NikhilMotagi/ModBusPlug/Illustration/ModbusPlug_Circuit1.png

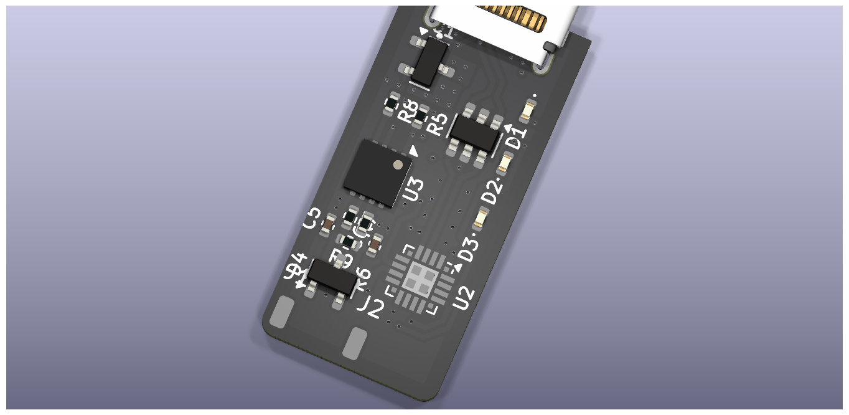
Illustration/ModbusPlug_Circuit1.png
