NikhilMotagi/ModBusPlug/Illustration/ModbusPlug_Circuit3.png

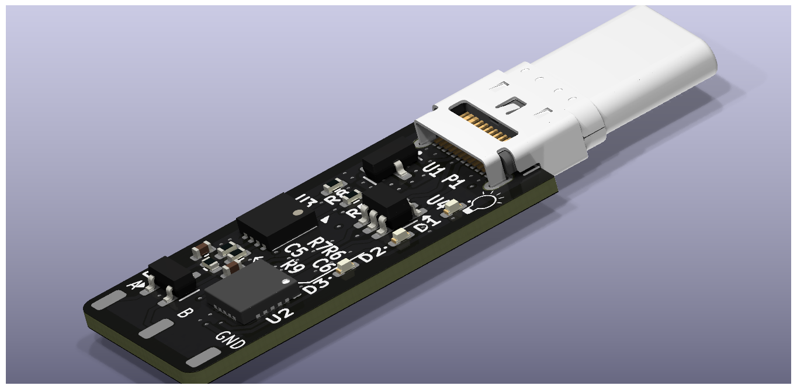
Illustration/ModbusPlug_Circuit3.png
