NikhilMotagi/ModBusPlug/Illustration/ModbusPlug_Circuit7.png

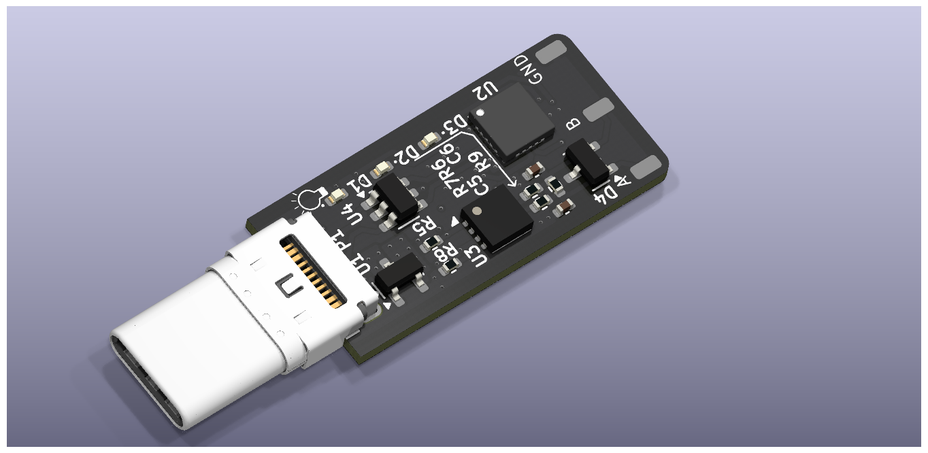
Illustration/ModbusPlug_Circuit7.png
