NikhilMotagi/ModBusPlug/Illustration/ModbusPlug_Circuit8.png

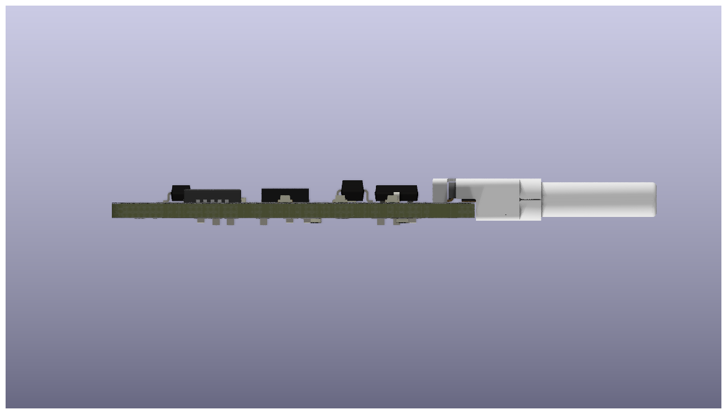
Illustration/ModbusPlug_Circuit8.png
