NikhilMotagi/ModBusPlug/Illustration/shell_1.png

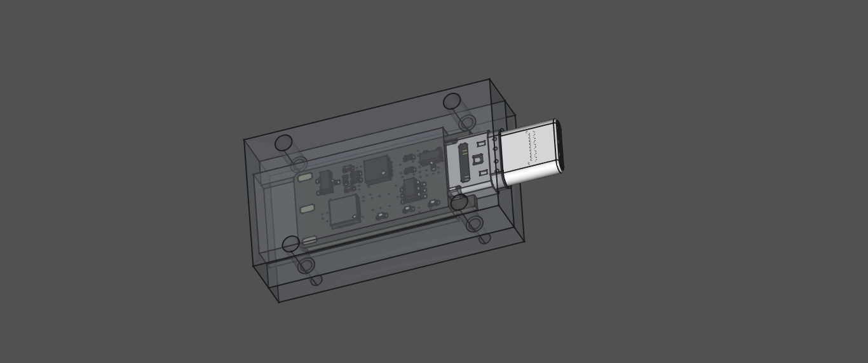
Illustration/shell_1.png
