NikhilMotagi/ModBusPlug/Illustration/shell_2.png

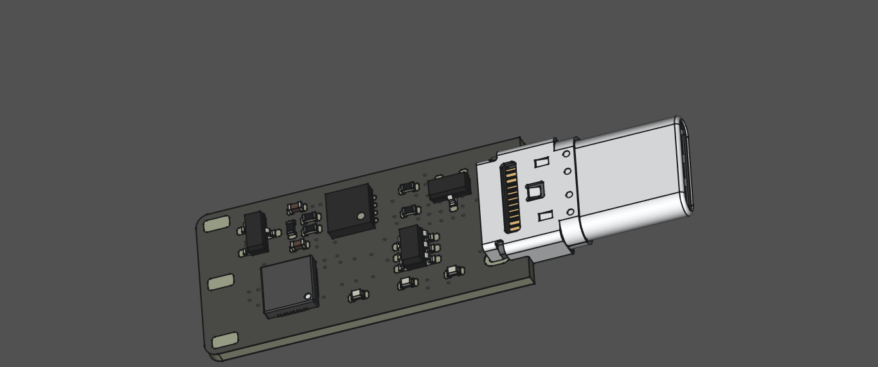
Illustration/shell_2.png
