NikhilMotagi/ModBusPlug/Illustration/shell_3.png

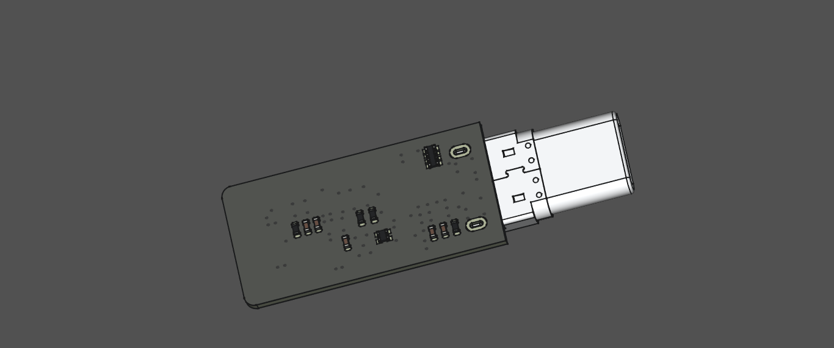
Illustration/shell_3.png
