NikhilMotagi/ModBusPlug/Illustration/shell_4.png

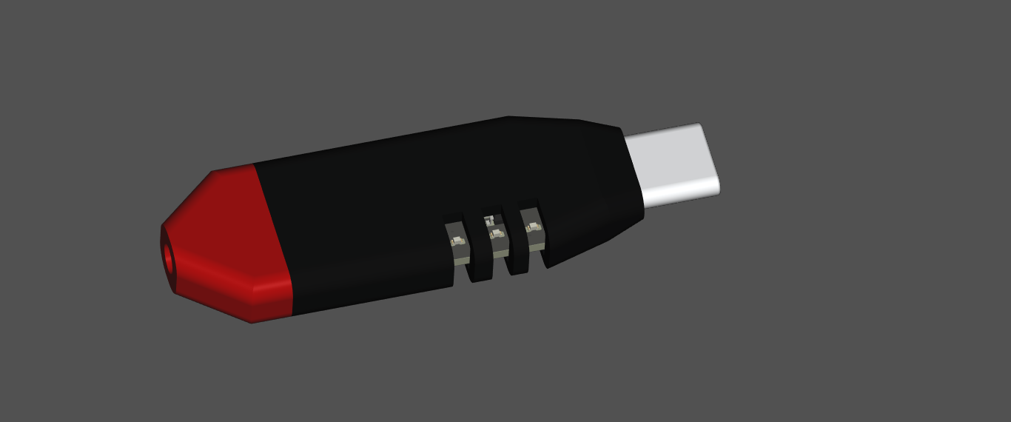
Illustration/shell_4.png
