NikhilMotagi/ModBusPlug/Illustration/shell_airender2.png

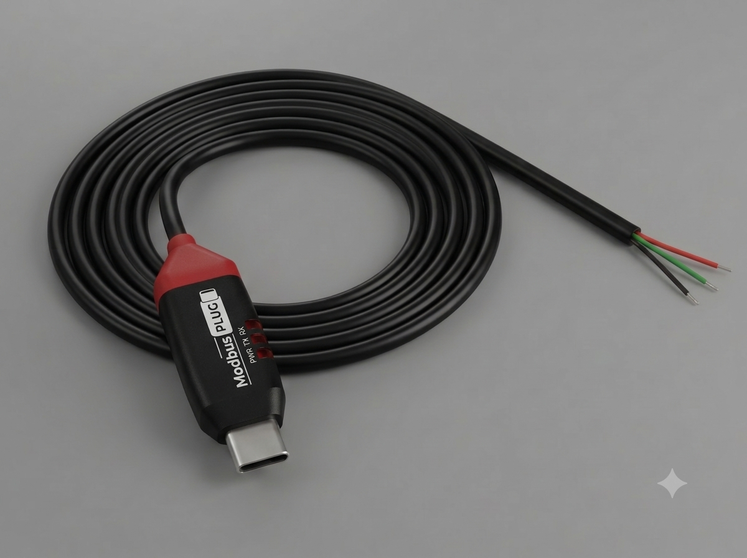
Illustration/shell_airender2.png
