NikhilMotagi/ModBusPlug/Media/BrigthLABS (1).png

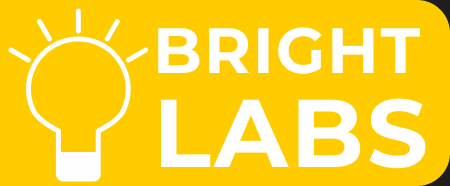
Media/BrigthLABS (1).png
