NikhilMotagi/ModBusPlug/Media/BrigthLABS.png

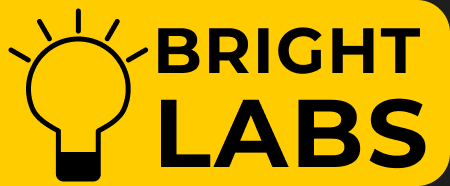
Media/BrigthLABS.png
