NikhilMotagi/ModBusPlug/Media/Gemini_Generated_Image_so0ew5so0ew5so0e.png

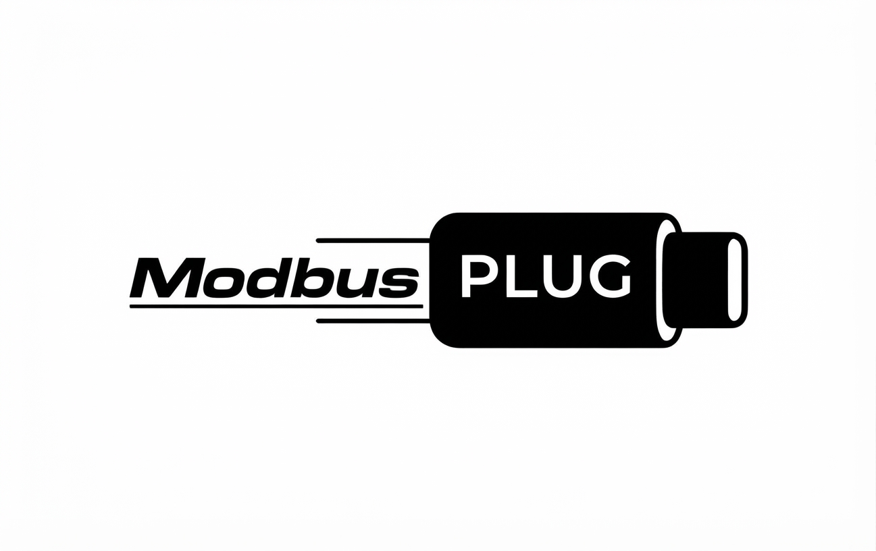
Media/Gemini_Generated_Image_so0ew5so0ew5so0e.png
