NikhilMotagi/ModBusPlug/Media/Modbus Plug with Color LEDs and Cable.png

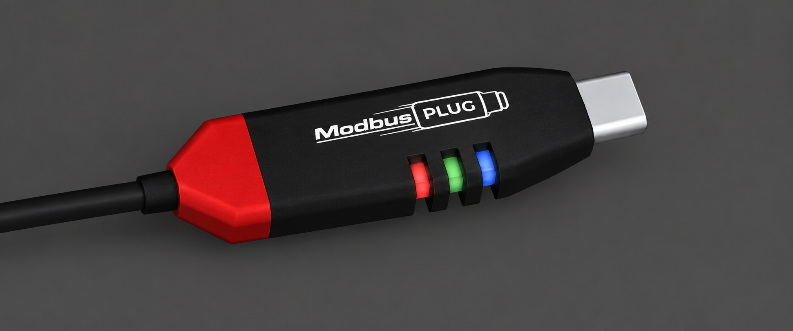
Media/Modbus Plug with Color LEDs and Cable.png
