NikhilMotagi/ModBusPlug/Media/OG OG Bulb Thick.png

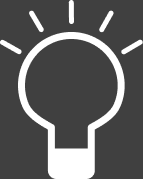
Media/OG OG Bulb Thick.png
