NikhilMotagi/ModBusPlug/Media/WhatsApp Image 2026-10-03 at 10.42.25 AM.jpeg

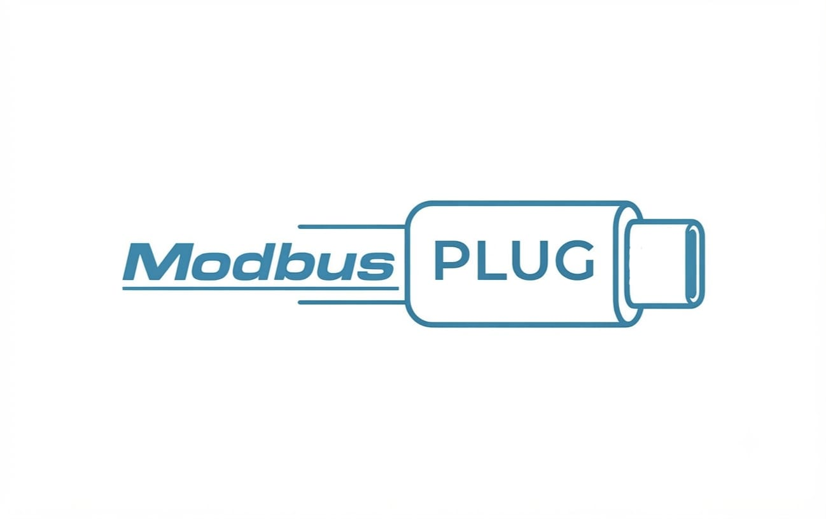
Media/WhatsApp Image 2026-10-03 at 10.42.25 AM.jpeg
