NikhilMotagi/ModBusPlug/Fab/ModbusPlug_Circuit-NPTH-drl_map.dxf

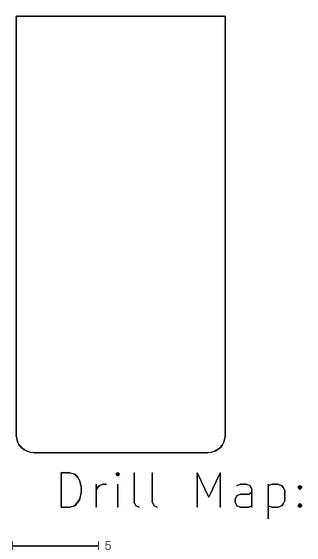
[picture p26: CAD file, 2026-10-03]
Fab/ModbusPlug_Circuit-NPTH-drl_map.dxf
16.4 x 28.9
