NikhilMotagi/ModBusPlug/ModbusPlug_Circuit/ModbusPlug_Library/3dCad/USB4155-03-C--3DModel-STEP-1.STEP

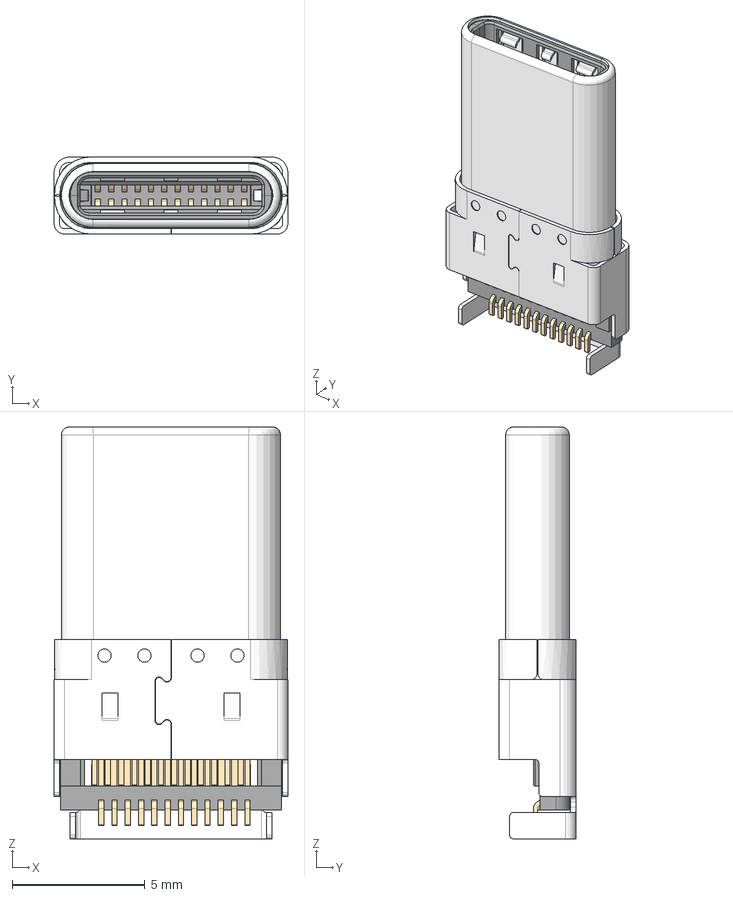
[picture p28: CAD file, 2026-09-18]
ModbusPlug_Circuit/ModbusPlug_Library/3dCad/USB4155-03-C--3DModel-STEP-1.STEP
8.80 x 2.90 x 15.5 mm
ÊäÈë1 x 7
ÇÐ³ý-ÀÉì2
