NikhilMotagi/ModBusPlug/Fab/ModbusPlug_Circuit-PTH-drl_map.dxf

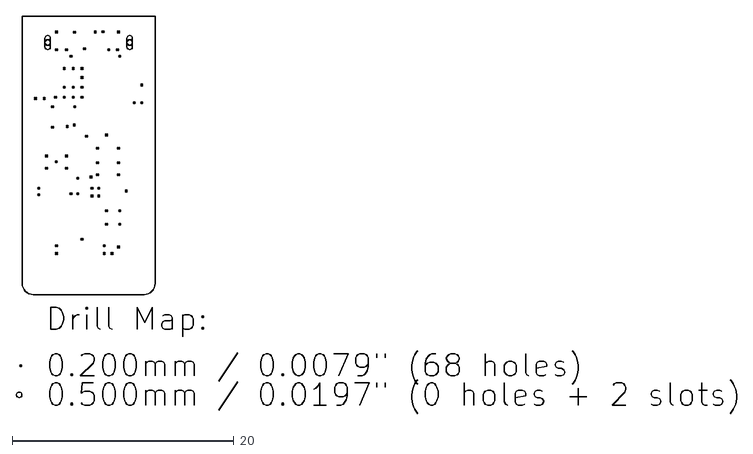
[picture p29: CAD file, 2026-10-03]
Fab/ModbusPlug_Circuit-PTH-drl_map.dxf
65.0 x 35.8
