NikhilMotagi/ModBusPlug/Illustration/PCB_Shell_v1.FCStd

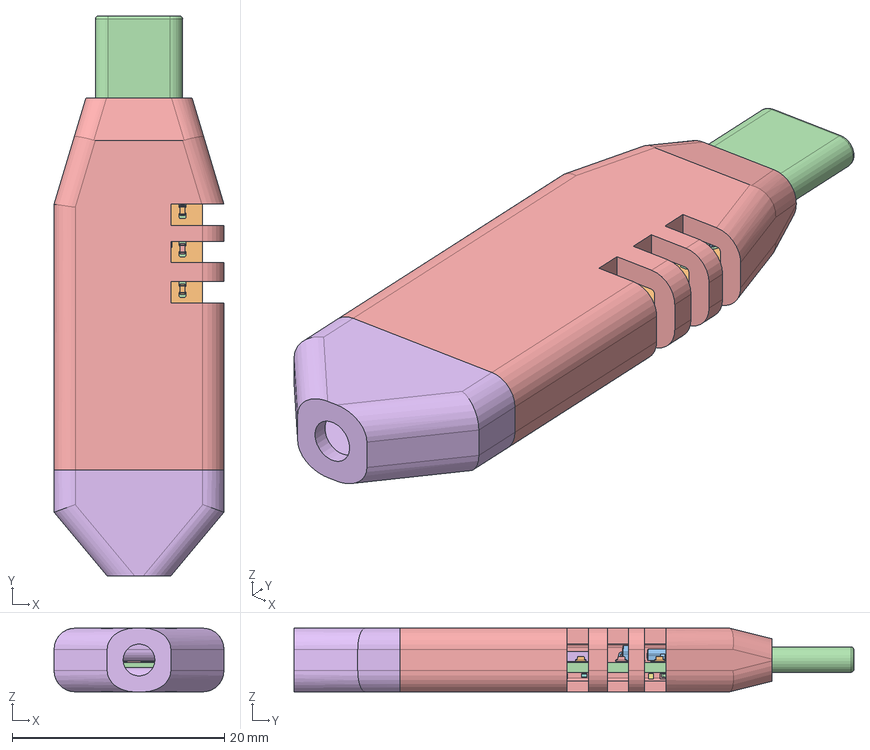
[picture p30: CAD file, 2026-10-17]
Illustration/PCB_Shell_v1.FCStd
16.0 x 52.7 x 6.00 mm
R_0402_1005Metric
LED_0402_1005Metric
SOT-23-6
ÃÂÃÂ¤ÃÂÃÂ«1
ÃÂÃÂ¤ÃÂÃÂ«002
ÃÂÃÂ¤ÃÂÃÂ«003
ÃÂÃÂ¤ÃÂÃÂ«004
ÃÂÃÂ¤ÃÂÃÂ«005
ÃÂÃÂ¤ÃÂÃÂ«006
ÃÂÃÂ¤ÃÂÃÂ«007
ÃÂÃÂ¤ÃÂÃÂ«008
ÃÂÃÂ¤ÃÂÃÂ«009
ÃÂÃÂ¤ÃÂÃÂ«010
ÃÂÃÂ¤ÃÂÃÂ«011
ÃÂÃÂ¤ÃÂÃÂ«012
ÃÂÃÂ¤ÃÂÃÂ«013
ÃÂÃÂ¤ÃÂÃÂ«014
ÃÂÃÂ¤ÃÂÃÂ«015
ÃÂÃÂ¤ÃÂÃÂ«016
ÃÂÃÂ¤ÃÂÃÂ«017
ÃÂÃÂ¤ÃÂÃÂ«018
ÃÂÃÂ¤ÃÂÃÂ«019
ÃÂÃÂ¤ÃÂÃÂ«020
ÃÂÃÂ¤ÃÂÃÂ«021
ÃÂÃÂ¤ÃÂÃÂ«022
ÃÂÃÂ¤ÃÂÃÂ«023
ÃÂÃÂ¤ÃÂÃÂ«024
ÃÂÃÂ¤ÃÂÃÂ«025
ÃÂÃÂ¤ÃÂÃÂ«026
ÃÂÃÂ¤ÃÂÃÂ«027
ÃÂÃÂ¤ÃÂÃÂ«028
ÃÂÃÂ¤ÃÂÃÂ«029
ÃÂÃÂ¤ÃÂÃÂ«030
ÃÂÃÂ¤ÃÂÃÂ«031
ÃÂÃÂ¤ÃÂÃÂ«032
ÃÂÃÂ¤ÃÂÃÂ«033
ÃÂÃÂ¤ÃÂÃÂ«034
ÃÂÃÂ¤ÃÂÃÂ«035
ÃÂÃÂ¤ÃÂÃÂ«036
ÃÂÃÂ¤ÃÂÃÂ«037
ÃÂÃÂ¤ÃÂÃÂ«038
ÃÂÃÂ¤ÃÂÃÂ«039
ÃÂÃÂ¤ÃÂÃÂ«040
ÃÂÃÂ¤ÃÂÃÂ«041
ÃÂÃÂ¤ÃÂÃÂ«042
ÃÂÃÂ¤ÃÂÃÂ«043
ÃÂÃÂ¤ÃÂÃÂ«044
ÃÂÃÂ¤ÃÂÃÂ«045
ÃÂÃÂ¤ÃÂÃÂ«046
ÃÂÃÂ¤ÃÂÃÂ«047
ÃÂÃÂ¤ÃÂÃÂ«048
ÃÂÃÂ¤ÃÂÃÂ«049
ÃÂÃÂ¤ÃÂÃÂ«050
ÃÂÃÂ¤ÃÂÃÂ«051
ÃÂÃÂ¤ÃÂÃÂ«052
ÃÂÃÂ¤ÃÂÃÂ«053
ÃÂÃÂ¤ÃÂÃÂ«054
ÃÂÃÂ¤ÃÂÃÂ«055
ÃÂÃÂ¤ÃÂÃÂ«056
ÃÂÃÂ¤ÃÂÃÂ«057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
