NikhilMotagi/ModBusPlug/Illustration/ModbusPlug_Circuit-NPTH-drl_map.dxf

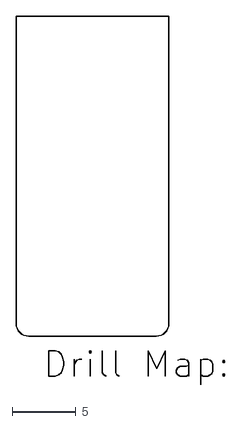
[picture p31: CAD file, 2026-10-03]
Illustration/ModbusPlug_Circuit-NPTH-drl_map.dxf
16.4 x 28.9
