NikhilMotagi/ModBusPlug/Illustration/ModbusPlug_Circuit.step

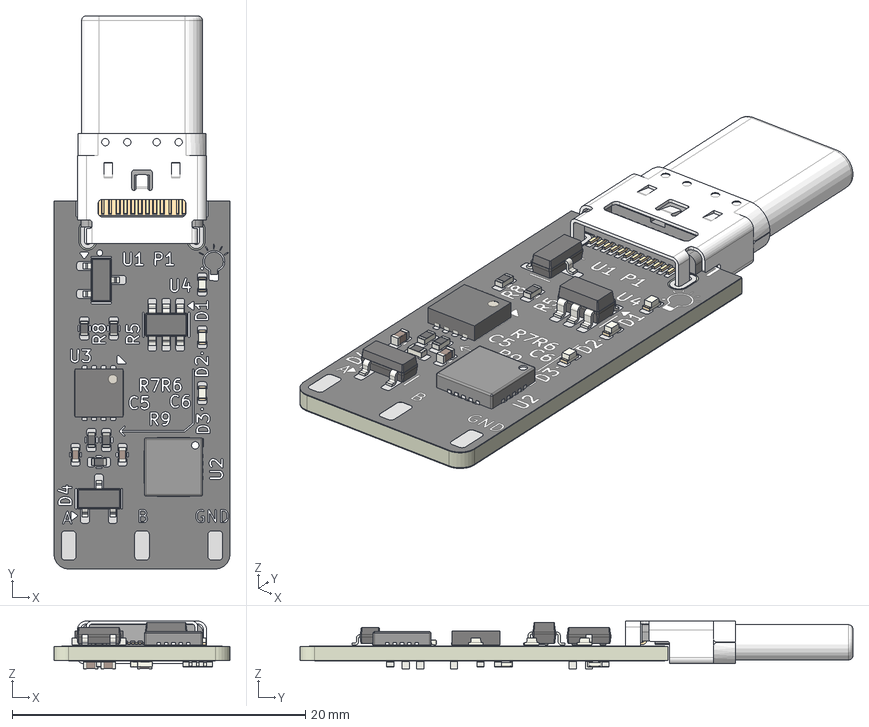
[picture p32: CAD file, 2026-10-03]
Illustration/ModbusPlug_Circuit.step
12.0 x 37.7 x 3.27 mm
R_0402_1005Metric x 9
LED_0402_1005Metric x 3
SOT-23-6
ÊäÈë1 x 7
ÇÐ³ý-ÀÉì2
SOT-23 x 2
C_0402_1005Metric x 7
VSON-8_3.3x3.3mm_P0.65mm_NexFET
R_Array_Convex_2x0402
R_Array_Convex_4x0402
ModbusPlug_Circuit_copper
ModbusPlug_Circuit_pad
ModbusPlug_Circuit_via
ModbusPlug_Circuit_silkscreen
ModbusPlug_Circuit_soldermask
ModbusPlug_Circuit_PCB
