NikhilMotagi/ModBusPlug/Illustration/ModbusPlug_Circuit-PTH-drl_map.dxf

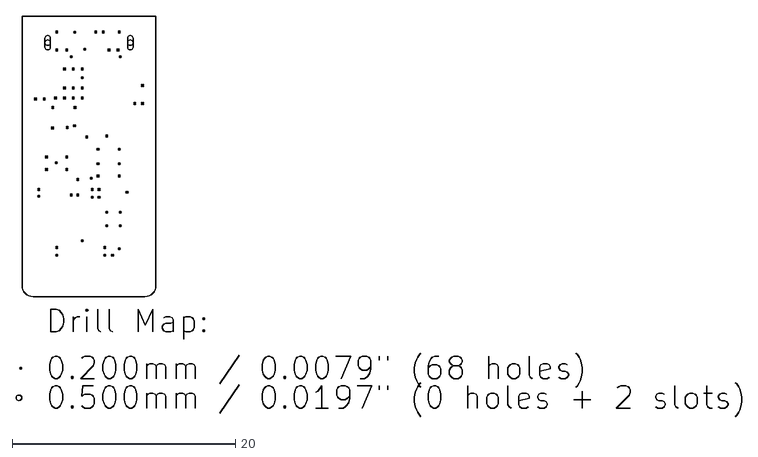
[picture p33: CAD file, 2026-10-03]
Illustration/ModbusPlug_Circuit-PTH-drl_map.dxf
65.0 x 35.8
