NikhilMotagi/ModBusPlug/ModbusPlug_Circuit/ModbusPlug_Circuit.kicad_pcb

## KiCad design ModbusPlug_Circuit/ModbusPlug_Circuit.kicad_pcb (2026-10-03)

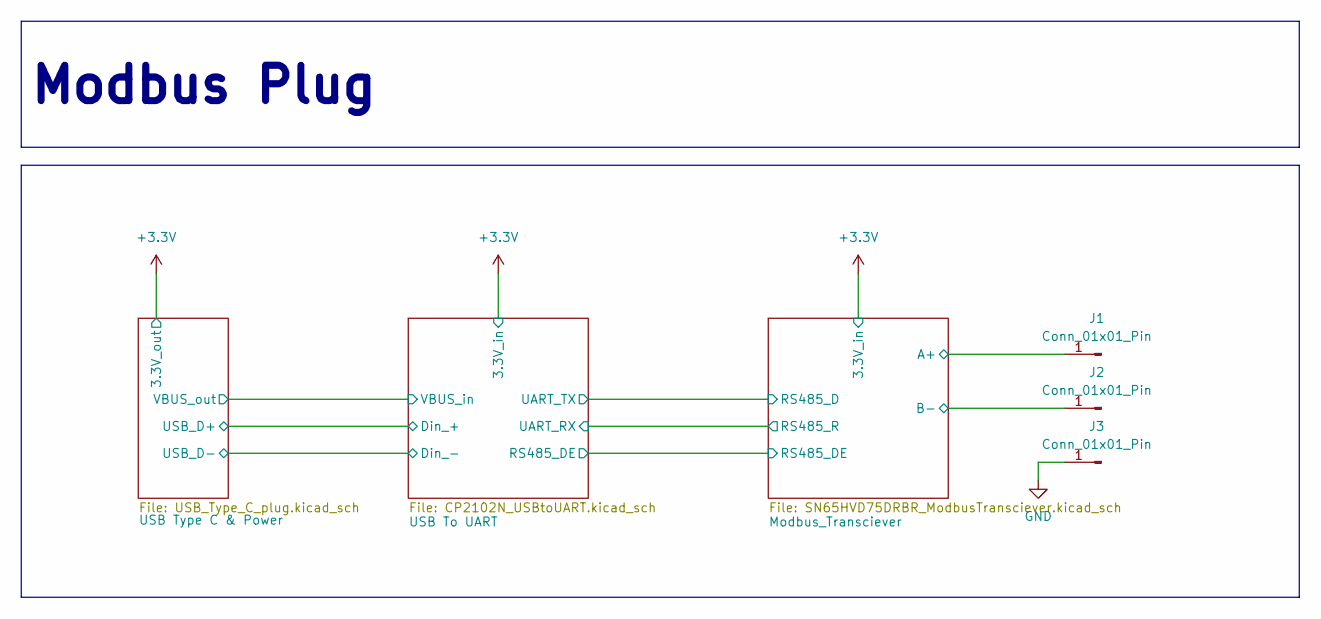
[picture p34: schematic ModbusPlug_Circuit.kicad_sch, ModbusPlug]

Parts:
J1, J2, J3: Conn_01x01_Pin; SolderWirePad_1x01_SMD_1x2mm

Connections:
/Modbus_Transciever/A+: J1.1; also elsewhere on the board
/Modbus_Transciever/B-: J2.1; also elsewhere on the board
GND: J3.1; also elsewhere on the board

Notes on the sheet:
Modbus Plug

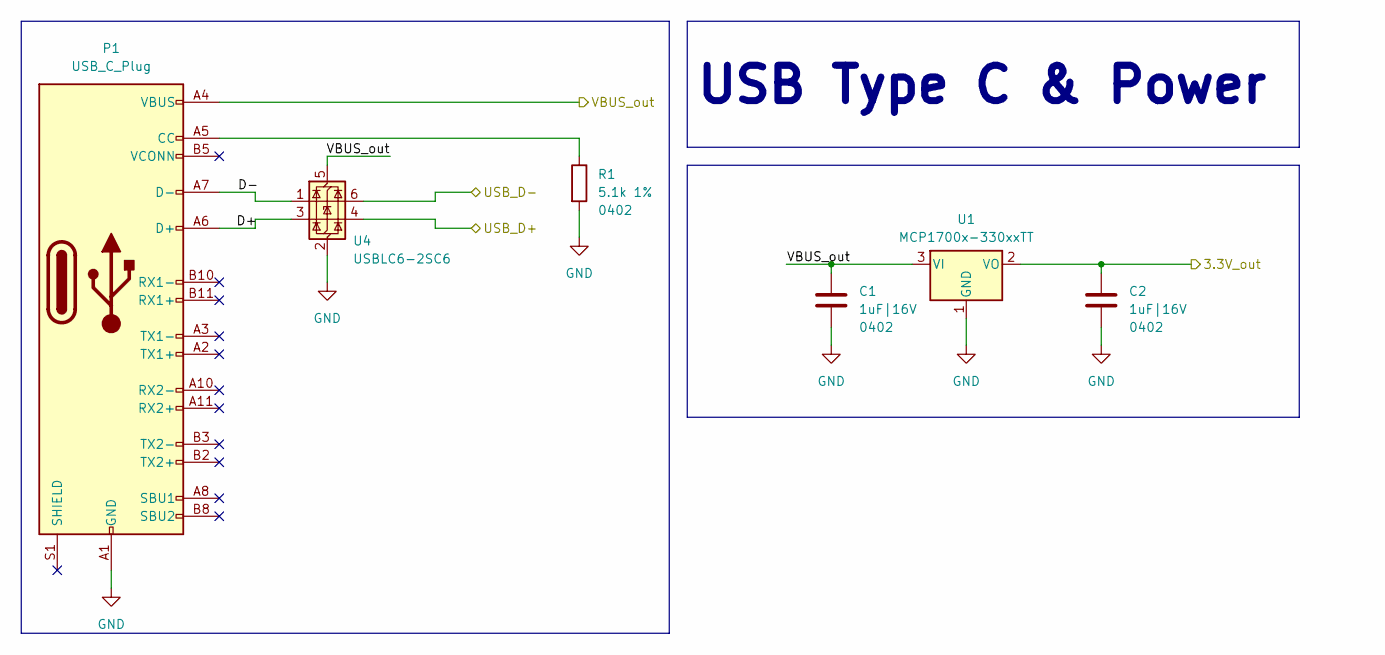
[picture p35: schematic USB_Type_C_plug.kicad_sch, ModbusPlug]

Parts:
C1, C2: 1uF|16V; C_0402_1005Metric
P1: USB_C_Plug; GCT_USB4155-03-C_REVA; PARTREV A
R1: 5.1k 1%; R_0402_1005Metric
U1: MCP1700x-330xxTT; SOT-23
U4: USBLC6-2SC6; SOT-23-6

Connections:
+3.3V: C2.1, U1.2 (VO); also elsewhere on the board
/USB To UART/Din_+: U4.4 (I/O2); also elsewhere on the board
/USB To UART/Din_-: U4.6 (I/O1); also elsewhere on the board
/USB Type C & Power/D+: P1.A6 (D+), P1.B6 (D+), U4.3 (I/O2)
/USB Type C & Power/D-: P1.A7 (D-), P1.B7 (D-), U4.1 (I/O1)
/USB Type C & Power/VBUS_out: C1.1, P1.A4 (VBUS), P1.A9 (VBUS), P1.B4 (VBUS), P1.B9 (VBUS), U1.3 (VI), U4.5 (VBUS); also elsewhere on the board
GND: C1.2, C2.2, P1.A1 (GND), P1.A12 (GND), P1.B1 (GND), P1.B12 (GND), R1.2, U1.1 (GND), U4.2 (GND); also elsewhere on the board
unnamed: P1.A5 (CC), R1.1

Notes on the sheet:
USB Type C & Power

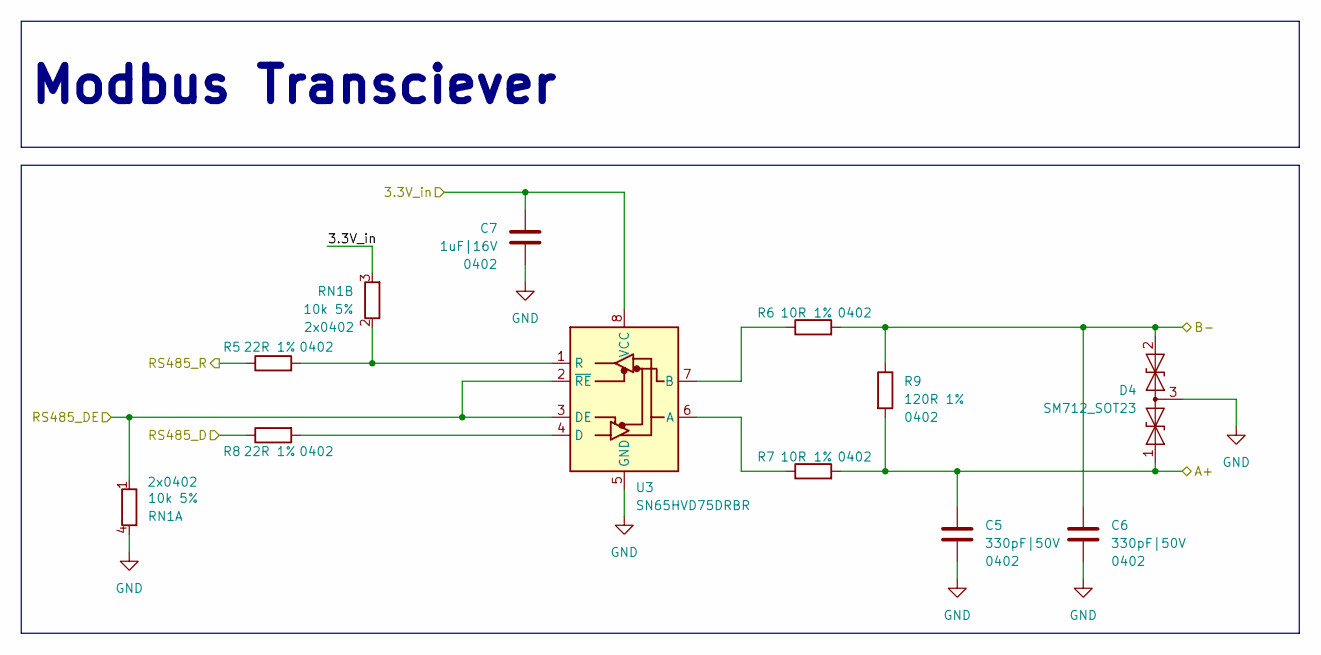
[picture p36: schematic SN65HVD75DRBR_ModbusTransciever.kicad_sch, ModbusPlug]

Parts:
C5, C6: 330pF|50V; C_0402_1005Metric
C7: 1uF|16V; C_0402_1005Metric
D4: SM712_SOT23; SOT-23
R5, R8: 22R 1%; R_0402_1005Metric
R6, R7: 10R 1%; R_0402_1005Metric
R9: 120R 1%; R_0402_1005Metric
RN1: 10k 5%; R_Array_Convex_2x0402
U3: SN65HVD75DRBR; VSON-8-1EP_3x3mm_P0.65mm_EP1.65x2.4mm

Connections:
+3.3V: C7.1, RN1.3 (R2.2), U3.8 (VCC); also elsewhere on the board
/Modbus_Transciever/A+: C5.1, D4.1 (A1), R7.2, R9.2; also elsewhere on the board
/Modbus_Transciever/B-: C6.1, D4.2 (A2), R6.2, R9.1; also elsewhere on the board
/Modbus_Transciever/RS485_D: R8.1; also elsewhere on the board
/Modbus_Transciever/RS485_DE: RN1.1 (R1.1), U3.2 (~RE), U3.3 (DE); also elsewhere on the board
/Modbus_Transciever/RS485_R: R5.1; also elsewhere on the board
GND: C5.2, C6.2, C7.2, D4.3 (common), RN1.4 (R1.2), U3.5 (GND), U3.9 (EPad); also elsewhere on the board
unnamed: R5.2, RN1.2 (R2.1), U3.1 (R)
unnamed: R7.1, U3.6 (A)
unnamed: R6.1, U3.7 (B)
unnamed: R8.2, U3.4 (D)

Notes on the sheet:
Modbus Transciever

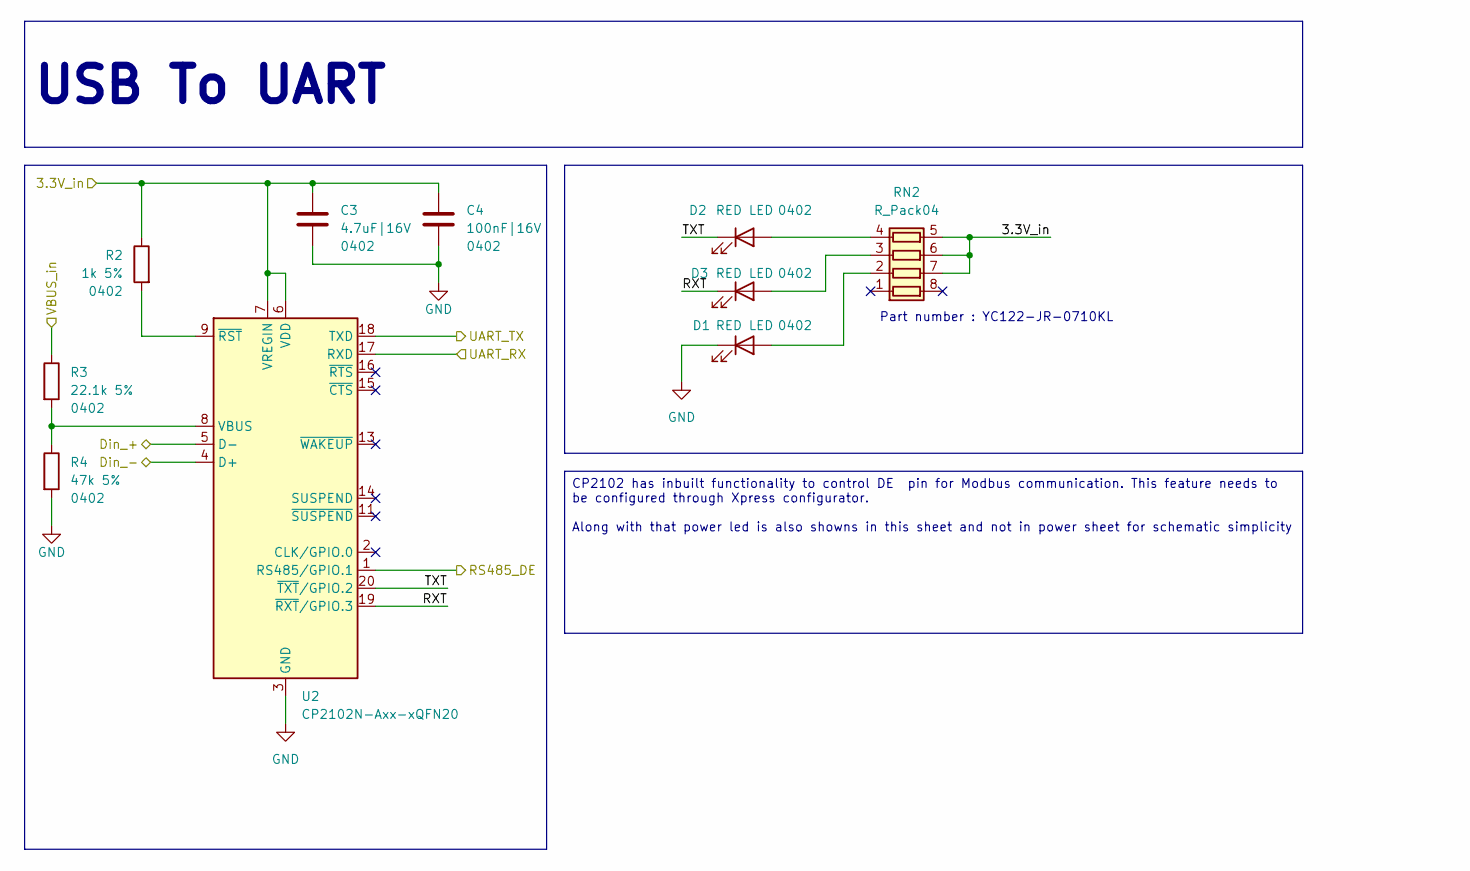
[picture p37: schematic CP2102N_USBtoUART.kicad_sch, ModbusPlug]

Parts:
C3: 4.7uF|16V; C_0402_1005Metric
C4: 100nF|16V; C_0402_1005Metric
D1, D2, D3: RED LED; LED_0402_1005Metric
R2: 1k 5%; R_0402_1005Metric
R3: 22.1k 5%; R_0402_1005Metric
R4: 47k 5%; R_0402_1005Metric
RN2: R_Pack04; R_Array_Convex_4x0402
U2: CP2102N-Axx-xQFN20; SiliconLabs_QFN-20-1EP_3x3mm_P0.5mm_EP1.8x1.8mm

Connections:
+3.3V: C3.1, C4.1, R2.1, RN2.5 (R4.2), RN2.6 (R3.2), RN2.7 (R2.2), U2.6 (VDD), U2.7 (VREGIN); also elsewhere on the board
/Modbus_Transciever/RS485_D: U2.18 (TXD); also elsewhere on the board
/Modbus_Transciever/RS485_DE: U2.1 (RS485/GPIO.1); also elsewhere on the board
/Modbus_Transciever/RS485_R: U2.17 (RXD); also elsewhere on the board
/USB To UART/Din_+: U2.5 (D-); also elsewhere on the board
/USB To UART/Din_-: U2.4 (D+); also elsewhere on the board
/USB To UART/RXT: D3.1 (K), U2.19 (~RXT/GPIO.3)
/USB To UART/TXT: D2.1 (K), U2.20 (~TXT/GPIO.2)
/USB Type C & Power/VBUS_out: R3.1; also elsewhere on the board
GND: C3.2, C4.2, D1.1 (K), R4.2, U2.3 (GND), U2.12 (GND), U2.21 (GND); also elsewhere on the board
unnamed: D1.2 (A), RN2.2 (R2.1)
unnamed: D2.2 (A), RN2.4 (R4.1)
unnamed: D3.2 (A), RN2.3 (R3.1)
unnamed: R3.2, R4.1, U2.8 (VBUS)
unnamed: R2.2, U2.9 (~RST)

Notes on the sheet:
Part number : YC122-JR-0710KL
CP2102 has inbuilt functionality to control DE pin for Modbus communication. This feature needs to be configured through Xpress configurator. Along with that power led is also showns in this sheet and not in power sheet for schematic simplicity
USB To UART

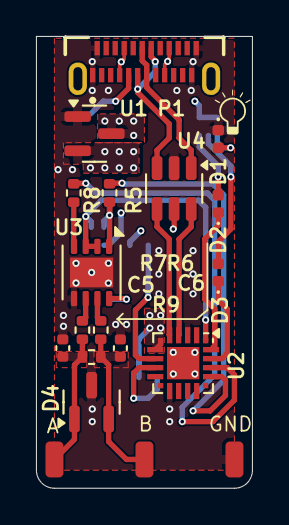
[picture p38: board ModbusPlug_Circuit.kicad_pcb from above]

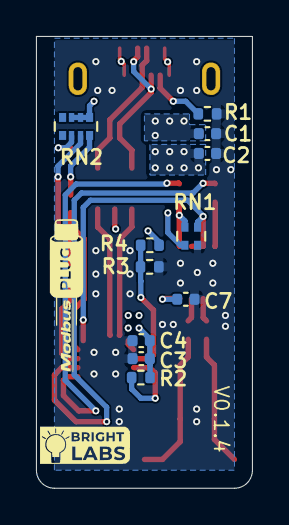
[picture p39: board ModbusPlug_Circuit.kicad_pcb from below]

Board: 4 copper layers, 12.0 x 25.1 mm, 30 parts (11 on the bottom side), 24 nets.
