NikhilMotagi/ModBusPlug/Documenation/version_history.txt

V0.1
Dated : 23-09-26
-Started SN65HVD75DRBR circuit schematic
-Added USBLS6 to Type C connector schematic
-Played with USBLS6, CP2102N component placement
-Added Net classes to PCB 
-Reduced Copper clearance to 0.1mm, in netclass setting (helped with the mysterious margin issue)
-Updated gitignore file

V0.1.1
Dated : 24-09-26
-Updated 3.3V power Hierarchical labels on all sheets
-Completed SN65HVD75DRBR circuit schematic
-Updated Board stackup count to 4 layers 
-Revised Netclasses as per new labels
-played with SN65HVD75DRBR component placement

V0.1.2
Dated : 27-09-26
-Updated PCB stackup setting, for impedance control.
-Updated component placement

V0.1.3
Dated : 29-09-26
-Updated 22 ohm network resistor arrangement for PCB routing convenience
-Completed signal routing, added fill shapes for power and ground for all layers
-Added QFN20 step file for 3d visualization  

V0.1.4
Dated : 01-10-26
-Added logo silkscreen
-Updated ref des silkscreen placement
-Checked and corrected DRC
-Adding Fab notations and PCB closure notes
-Added Title blocks and boxes for schematic layout
