NikhilMotagi/ModBusPlug/(notices)

Notices in the files:
ModbusPlug_Circuit/ModbusPlug_Library/3dCad/USB4155-03-C--3DModel-STEP-1.STEP:
FILE_NAME( 'p:/temp/worker_31/temp/exporttempdir_2752_316_KL1O8/format_0/USB4155-03-C.stp', '2021-07-29T14:43:43', ( 'License CC BY-ND 4.0' ), ( 'CADENAS' ), ' ', 'PARTsolutions', ' ' );
README.md:
License: MIT
